kipman725/MegaPlateAmp/Sims/CurrentMonMorbid/gain_peaking.png

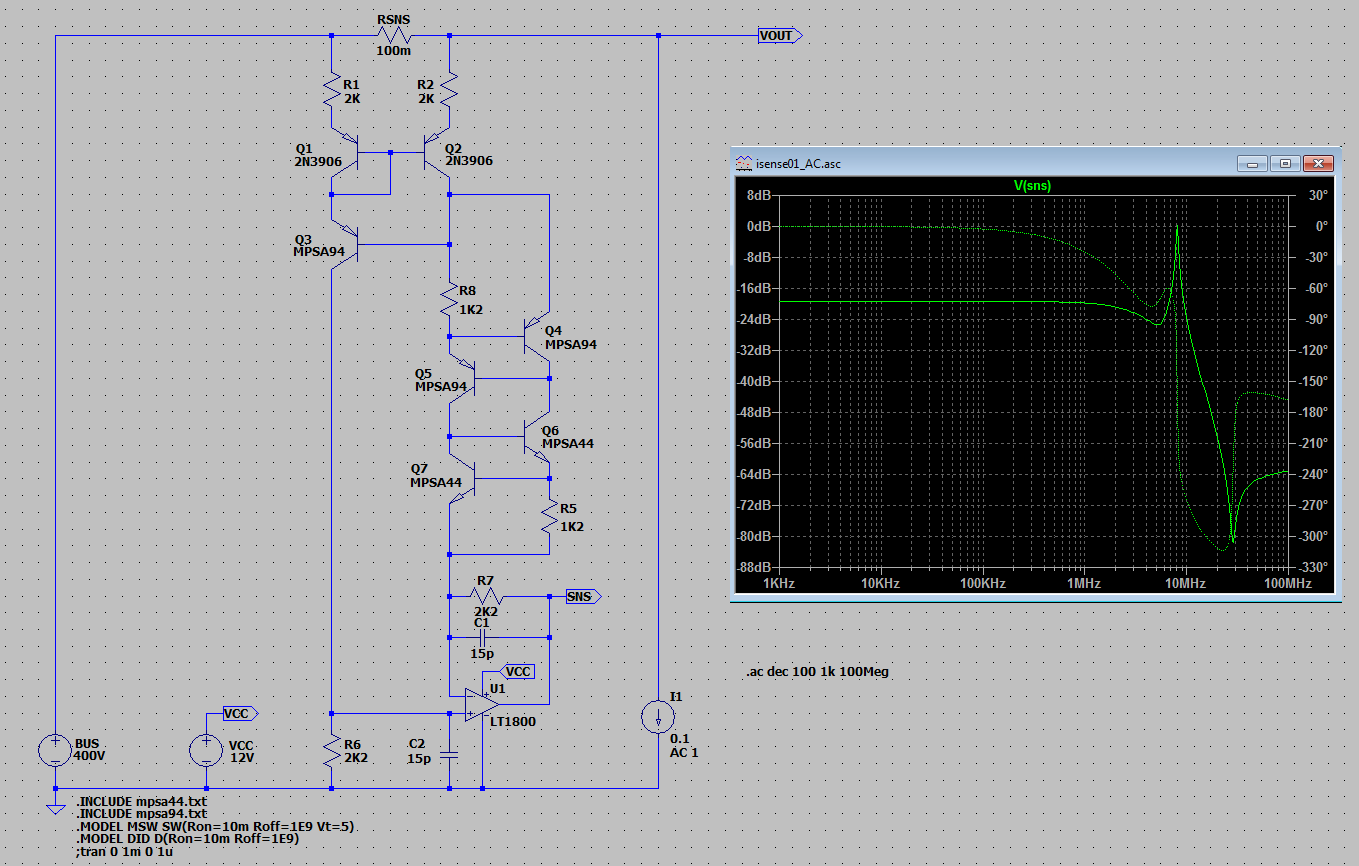
Sims/CurrentMonMorbid/gain_peaking.png
