kipman725/MegaPlateAmp/Sims/CurrentMonMorbid/linearity.png

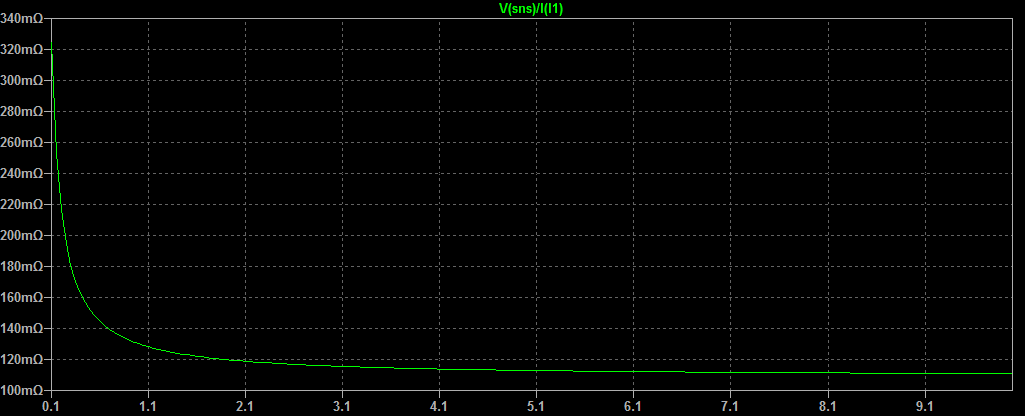
Sims/CurrentMonMorbid/linearity.png
