kipman725/MegaPlateAmp/MCU docs/LAUNCHXL_F28027_BOM.xls

Texas Instruments |  |  |  |  |  | Part Number | LAUNCHXL-F28027
Bill Of Materials for C2000 Launchpad |  |  |  |  |  | Asmbly Gnum
Bill Of Materials |  |  |  |  |  | Created | 2011-08-22
Item | Ref | Varient | Qty | Description | Notes | Mfg | Part Number | Vendor | Stk Number | Unit Cost | Line Cost
 | R12, R13, R14, R15, R26, R27 | All | 6 | RES 330 OHM 1/10W 5% 0402 SMD |  | Panasonic - ECG (http://digikey.com/Suppliers/us/Panasonic-Electronic-Components.page?lang=EN) | ERJ-2GEJ331X | Digikey | P330JTR-ND | 0.002 | 0.01
 | R1, R4, R5, R17 | All | 4 | RES 820 OHM 1/10W 5% 0402 SMD |  | Panasonic - ECG (http://digikey.com/Suppliers/us/Panasonic-Electronic-Components.page?lang=EN) | ERJ-2GEJ821X | Digikey | P820JTR-ND | 0.002 | 0.01
 | R22, R23 | All | 2 | RES 1.0K OHM 1/10W 5% 0402 SMD |  | Panasonic - ECG (http://digikey.com/Suppliers/us/Panasonic-Electronic-Components.page?lang=EN) | ERJ-2GEJ102X | Digikey | P1.0KJTR-ND | 0.002 | 0.0032
 | R6, R8, R9, R10, R31 | All | 5 | RES 2.2K OHM 1/10W 5% 0402 SMD |  | Panasonic - ECG (http://digikey.com/Suppliers/us/Panasonic-Electronic-Components.page?lang=EN) | ERJ-2GEJ222X | Digikey | P2.2KJTR-ND | 0.002 | 0.01
 | R11, R29 | All | 2 | RES 10K OHM 1/10W 5% 0402 SMD |  | Panasonic - ECG (http://digikey.com/Suppliers/us/Panasonic-Electronic-Components.page?lang=EN) | ERJ-2GEJ103X | Digikey | P10KJTR-ND | 0.002 | 0.0032
 | R24 | All | 1 | RES 12K OHM 1/16W .5% 0402 SMD |  | Panasonic - ECG (http://digikey.com/Suppliers/us/Panasonic-Electronic-Components.page?lang=EN) | ERA-2AED123X | Digikey | P12KDETR-ND | 0.026 | 0.03
 | R7 | All | 1 | RES 1.0M OHM 1/10W 5% 0402 SMD | No-pop | Panasonic - ECG (http://digikey.com/Suppliers/us/Panasonic-Electronic-Components.page?lang=EN) | ERJ-2GEJ105X | Digikey | P1.0MJTR-ND | 0.0016 | 0.0016
 | R16, R18, R19, R20, R21, R25, R28, R30, R32 | Non-Iso | 9 | RES 0.0 OHM 1/4W 1206 SMD |  | Panasonic - ECG (http://digikey.com/Suppliers/us/Panasonic-Electronic-Components.page?lang=EN) | ERJ-8GEY0R00V | Digikey | P0.0ETR-ND | 0.0023 | 0.02
 | L1, L2 | All | 2 | FERRITE BEAD 600 OHM 0402 |  | Taiyo Yuden (http://digikey.com/Suppliers/us/Taiyo-Yuden.page?lang=EN) | BK1005HM601-T | Digikey | 587-1839-2-ND | 0.012 | 0.02
 | L3 | All | 1 | FERRITE BEAD 220 OHM 0402 |  | Taiyo Yuden (http://digikey.com/Suppliers/us/Taiyo-Yuden.page?lang=EN) | BKP1005HS221-T | Digikey | 587-2088-1-ND | 0.02325 | 0.02
 | L4 | All | 1 | FERRITE CHIP 60 OHM 1.5A 0402 |  | TDK Corporation (http://digikey.com/Suppliers/us/TDK.page?lang=EN) | MPZ1005S600C | Digikey | 445-2980-2-ND | 0.018 | 0.02
 | C9, C12, C13, C14, C16 | All | 5 | CAP .10UF 16V CERAMIC Y5V 0402 |  | Yageo (http://digikey.com/Suppliers/us/Yageo.page?lang=EN) | CC0402ZRY5V7BB104 | Digikey | 311-1047-2-ND | 0.0012 | 0.01
 | C7 | All | 1 | CAP CER 1.0UF 6.3V X5R 20% 0402 |  | TDK Corporation (http://digikey.com/Suppliers/us/TDK.page?lang=EN) | C1005X5R0J105M | Digikey | 445-1415-2-ND | 0.004 | 0.004
 | C5, C6, C19, C20, C21 | All | 5 | CAP CER 2.2UF 6.3V 20% X5R 0402 |  | Taiyo Yuden (http://digikey.com/Suppliers/us/Taiyo-Yuden.page?lang=EN) | JMK105BJ225MV-F | Dugu | 587-1453-2-ND | 0.022 | 0.11
 | C15 | All | 1 | CAP CER 3.3UF 4.0V X5R 0402 |  | Taiyo Yuden (http://digikey.com/Suppliers/us/Taiyo-Yuden.page?lang=EN) | AMK105BJ335MV-F | Digikey | 587-2236-2-ND | 0.040 | 0.04
 | C10, C11 | All | 2 | CAP CER 4.7UF 4V X5R 0402 |  | Taiyo Yuden (http://digikey.com/Suppliers/us/Taiyo-Yuden.page?lang=EN) | AMK105BJ475MV-F | Digikey | 587-1966-2-ND | 0.058 | 0.12
 | C3, C4 | All | 2 | CAP CER 36PF 50V C0G 0402 | No-pop | TDK Corporation (http://digikey.com/Suppliers/us/TDK.page?lang=EN) | C1005C0G1H360J | Digikey | 445-4903-2-ND | 0.003 | 0.01
 | C17, C18 | All | 2 | CAP CER 36PF 50V C0G 0402 |  | TDK Corporation (http://digikey.com/Suppliers/us/TDK.page?lang=EN) | C1005C0G1H360J | Digikey | 445-4903-2-ND | 0.003 | 0.01
 | C8 | All | 1 | CAP TANTALUM 100UF 6.3V 10% SMD |  | Nichicon (http://digikey.com/Suppliers/us/Nichicon.page?lang=EN) | F930J107KBA | Digikey | 493-4109-2-ND | 0.116 | 0.12
 | F1 | All | 1 | PTC RESETTABLE .50A 15V 1812 |  | Bourns Inc. (http://digikey.com/Suppliers/us/Bourns.page?lang=EN) | MF-MSMF050-2 | Digikey | MF-MSMF050-2TR-ND | 0.071 | 0.07
 | S1 | All | 1 | SWITCH DIP 3POS TOP SLIDE SMT |  | CTS Electrocomponents (http://digikey.com/Suppliers/us/CTS-Corporation-Electrocomponents.page?lang=EN) | 204-3ST | Digikey | CT2043ST-ND | 0.491 | 0.49
 | S4 | All | 1 | SWITCH DIP DPST 1POS SMT |  | CTS Electrocomponents (http://digikey.com/Suppliers/us/CTS-Corporation-Electrocomponents.page?lang=EN) | 204-211ST | Digikey | CT204211ST-ND | 0.486 | 0.49
 | S2, S3 | All | 2 | SW TACT SPST-NO MOM 160GF SMD |  | TE Connectivity (http://digikey.com/Suppliers/us/Tyco-Electronics-Alcoswitch.page?lang=EN) | FSM2JSMATR | Digikey | 450-1757-2-ND | 0.117 | 0.23
 | Q1, Q2 | All | 1 | Crystal | No-pop |  |  |  |  | 0.000 | 0.00
 | Q3 | All | 1 | CRYSTAL 12.0000 MHZ 18PF SMD |  | Abracon Corporation (http://digikey.com/Suppliers/us/Abracon.page?lang=EN) | ABLS2-12.000MHZ-D4Y-T | Digikey | 535-9869-2-ND | 0.204 | 0.20
 | D6 | All | 1 | LED RED HIGH BRIGHT ESS SMD |  | Panasonic - SSG (http://digikey.com/Suppliers/us/Panasonic-Semiconductors.page?lang=EN) | LNJ237W82RA | Digikey | LNJ237W82RATR-ND | 0.045 | 0.04
 | D1 | All | 1 | LED GREEN HIGH BRIGHT ESS SMD |  | Panasonic - SSG (http://digikey.com/Suppliers/us/Panasonic-Semiconductors.page?lang=EN) | LNJ337W83RA | Digikey | LNJ337W83RATR-ND | 0.06 | 0.06
 | D2, D3, D4, D5, D7, D8 | All | 6 | LED BLUE HIGH BRIGHT ESS SMD |  | Panasonic - SSG (http://digikey.com/Suppliers/us/Panasonic-Semiconductors.page?lang=EN) | LNJ937W8CRA | Digikey | LNJ937W8CRATR-ND | 0.08 | 0.48
 |  | All |  |  |  |  |  |  |  |  | 0.00
 | JP1, JP2, JP3 | Iso | 3 | BERGSTIK II .100" SR STRAIGHT |  | FCI (http://digikey.com/Suppliers/us/FCI.page?lang=EN) | 68001-102HLF | Digikey | 609-3506-ND | 0.08 | 0.24
 | J1 & J5, J2 & J6 | All | 2 | CONN HEADER .100 DUAL STR 20POS |  | 3M (http://digikey.com/Suppliers/us/3M.page?lang=EN) | 929665-03-10-I | Digikey | 929665-03-10-ND | 3.1 | 6.20
 | J3 | All | 1 | CONN HEADER .100 SNGL STR 3POS |  | 3M (http://digikey.com/Suppliers/us/3M.page?lang=EN) | 929647-03-03-I | Digikey | 929647-03-03-ND | 0.88 | 0.88
 | CON1 | All | 1 | CONN RECEPT MINI-USB TYPE B SMT |  | Mill-Max Manufacturing Corp. (http://digikey.com/Suppliers/us/Mill-Max.page?lang=EN) | 897-43-005-00-100001 | Digikey | ED90341TR-ND | 0.44 | 0.44
 |  | All |  |  |  |  |  |  |  |  | 0.00
 | U4 | All | 1 | IC LDO REG 800MA 3.3V SOT223-4 |  | Texas Instruments (http://digikey.com/Suppliers/us/Texas-Instruments.page?lang=EN) | TLV1117-33CDCYR | Digikey | 296-21112-2-ND | 0.192 | 0.19
 | U2, U3 | All | 2 | IC BUFF/DVR DL NON-INV SOT236 |  | Texas Instruments (http://digikey.com/Suppliers/us/Texas-Instruments.page?lang=EN) | SN74LVC2G07DBVR | Digikey | 296-13494-2-ND | 0.083 | 0.17
 | U5 | All | 1 | ISOLAT DGTL 2.5KVRMS 4CH 16-SOIC |  | Texas Instruments (http://digikey.com/Suppliers/us/Texas-Instruments.page?lang=EN) | ISO7240CDWR | Digikey | ISO7240CDWR-ND | 1.912 | 1.91
 | U7 | All | 1 | ISOLAT DGTL 3KVRMS 3CH 16-SOIC |  | Texas Instruments (http://digikey.com/Suppliers/us/Texas-Instruments.page?lang=EN) | ISO7231CDWR | Digikey | ISO7231CDWR-ND | 1.51 | 1.51
 | U6 | All | 1 | IC USB HS DUAL UART/FIFO 64-QFN |  | FTDI, Future Technology Devices International Ltd (http://digikey.com/Suppliers/us/Future-Technology-Devices.page?lang=EN) | FT2232HQ-REEL | Digikey | 768-1025-2-ND | 3.6 | 3.60
 | U8 | All | 1 | IC EEPROM 2KBIT 3MHZ SOT23-6 |  | Microchip Technology (http://digikey.com/Suppliers/us/Microchip-Technology.page?lang=EN) | 93LC56BT-I/OT | Digikey | 93LC56BT-I/OTTR-ND | 0.2 | 0.20
 | U1 | All | 1 | IC MCU 32BIT 64KB FLASH 48LQFP |  | Texas Instruments (http://digikey.com/Suppliers/us/Texas-Instruments.page?lang=EN) | TMS320F28027PTS | Digikey | TMS320F28027PTS-ND | 4.020 | 4.02
 |  |  | 1 |  |  |  |  |  |  |  | 0.00 | - | 7.80 | = | 14.18
 |  |  |  |  |  |  |  |  |  |  | 21.98
Note: All Items with Texas Instruments listed as vendor will be consigned by Texas Instruments
