kipman725/MegaPlateAmp/PCB/ECAD/LM2776DBVR.stp

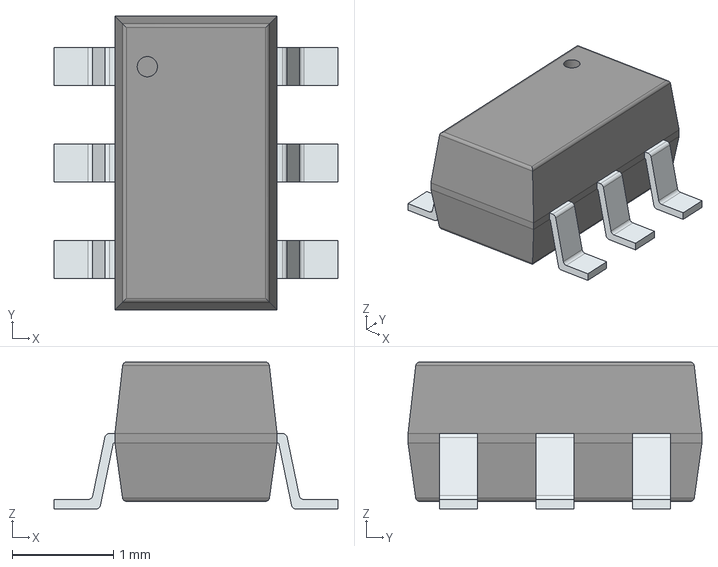
[picture p16: CAD file, 2020-05-20]
PCB/ECAD/LM2776DBVR.stp
2.80 x 2.90 x 1.45 mm
PinsArrayLR
