kipman725/MegaPlateAmp/PCB/ECAD/DST3906DJ-7.stp

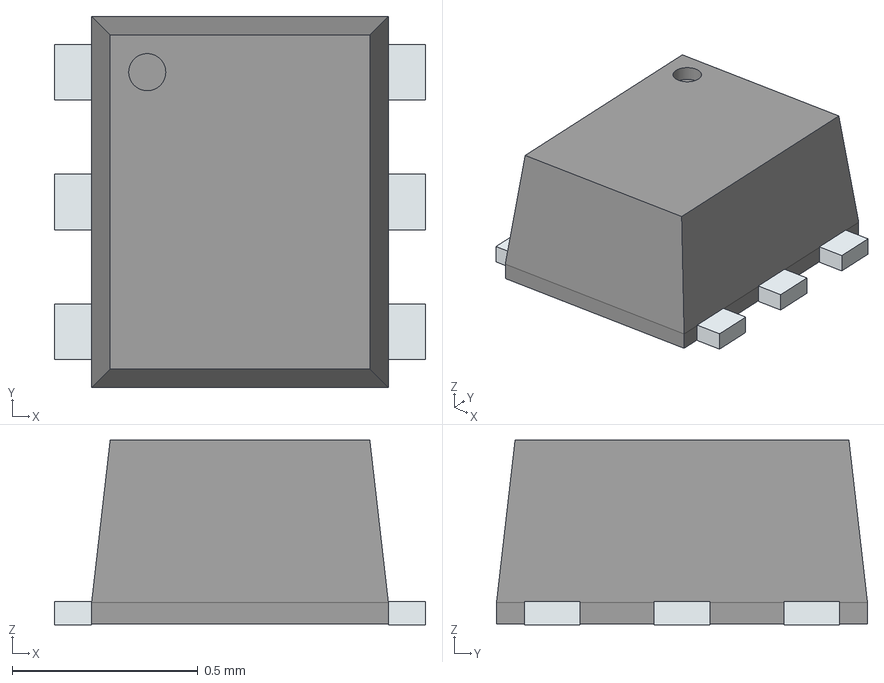
[picture p17: CAD file, 2020-05-20]
PCB/ECAD/DST3906DJ-7.stp
1.00 x 1.00 x 0.498 mm
PinsArrayL
PinsArrayR
