kipman725/MegaPlateAmp/PCB/ECAD/TMS320F28027FPTT.stp

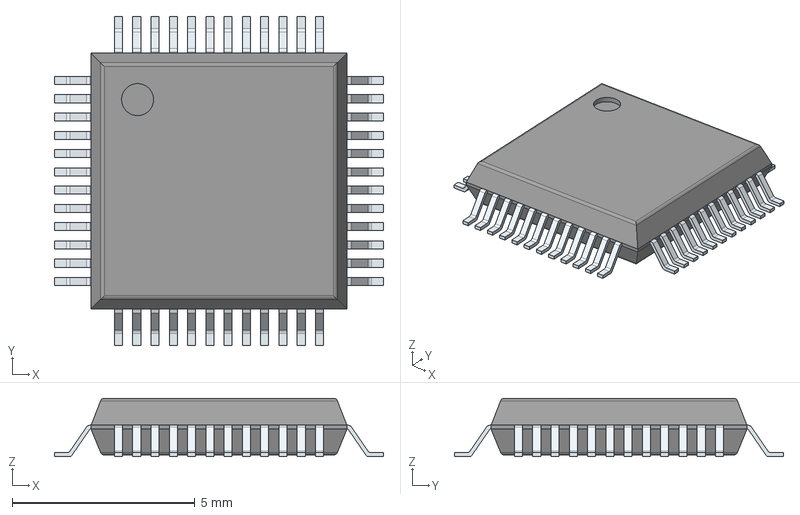
[picture p18: CAD file, 2020-05-20]
PCB/ECAD/TMS320F28027FPTT.stp
9.00 x 9.00 x 1.60 mm
PinsArrayLR
PinsArrayTB
