kipman725/MegaPlateAmp/PCB/ECAD/ALC70C332FP350.stp

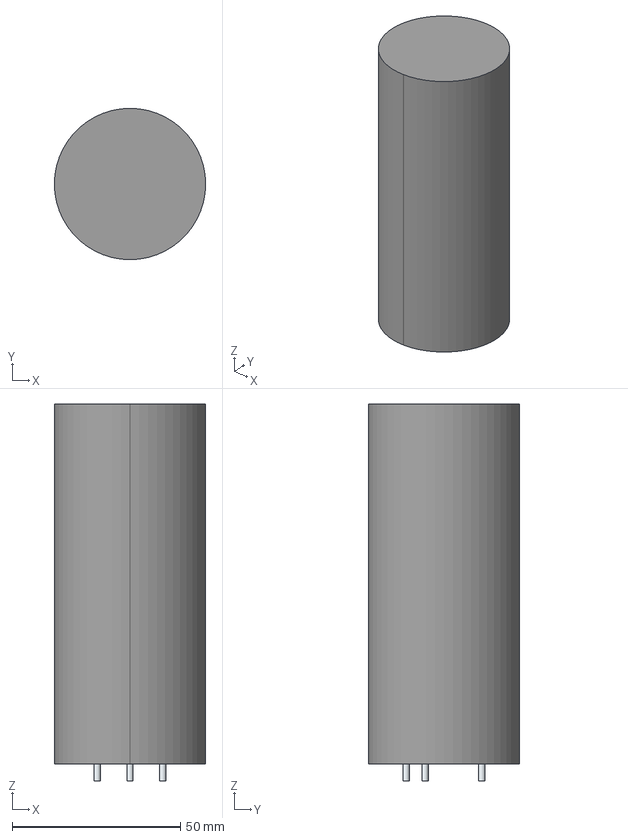
[picture p19: CAD file, 2020-04-15]
PCB/ECAD/ALC70C332FP350.stp
45.0 x 45.0 x 112.1 mm
Leads x 4
