kipman725/MegaPlateAmp/PCB/ECAD/74437529203221.stp

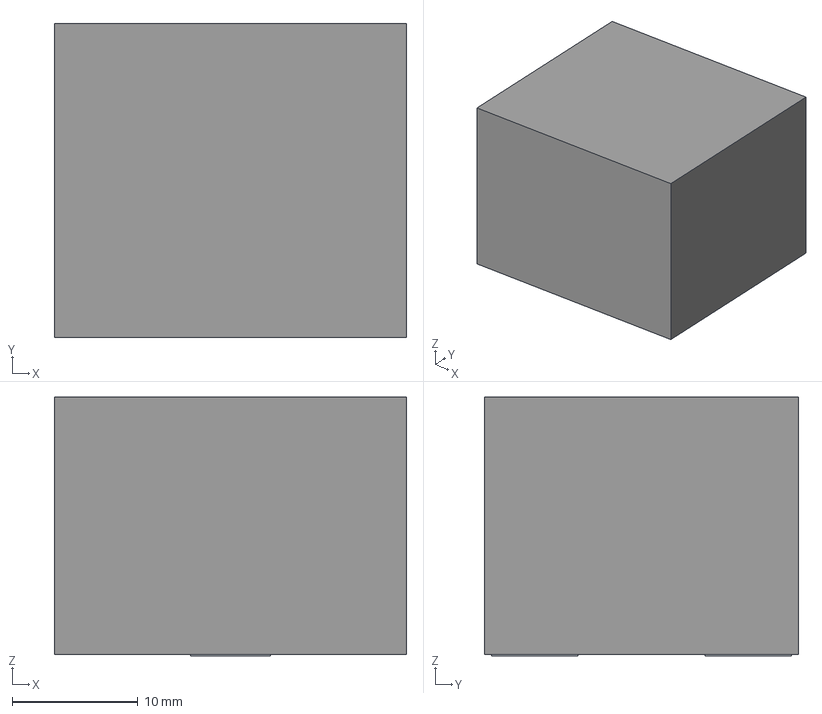
[picture p20: CAD file, 2020-05-20]
PCB/ECAD/74437529203221.stp
28.0 x 25.0 x 20.6 mm
Pins
