kipman725/MegaPlateAmp/(list of files, cad)

Other CAD files:
PCB/ECAD/TPS70950DBVR.stp
PCB/ECAD/74437529203221.stl
PCB/ECAD/ALC70C332FP350.stl
PCB/ECAD/DST3906DJ-7.stl
PCB/ECAD/LM2776DBVR.stl
PCB/ECAD/SI8274GB1-IM1.stl
PCB/ECAD/TMS320F28027FPTT.stl
PCB/ECAD/TPS70950DBVR.stl
