kipman725/MegaPlateAmp/Documentation/basic_diagram.pdf

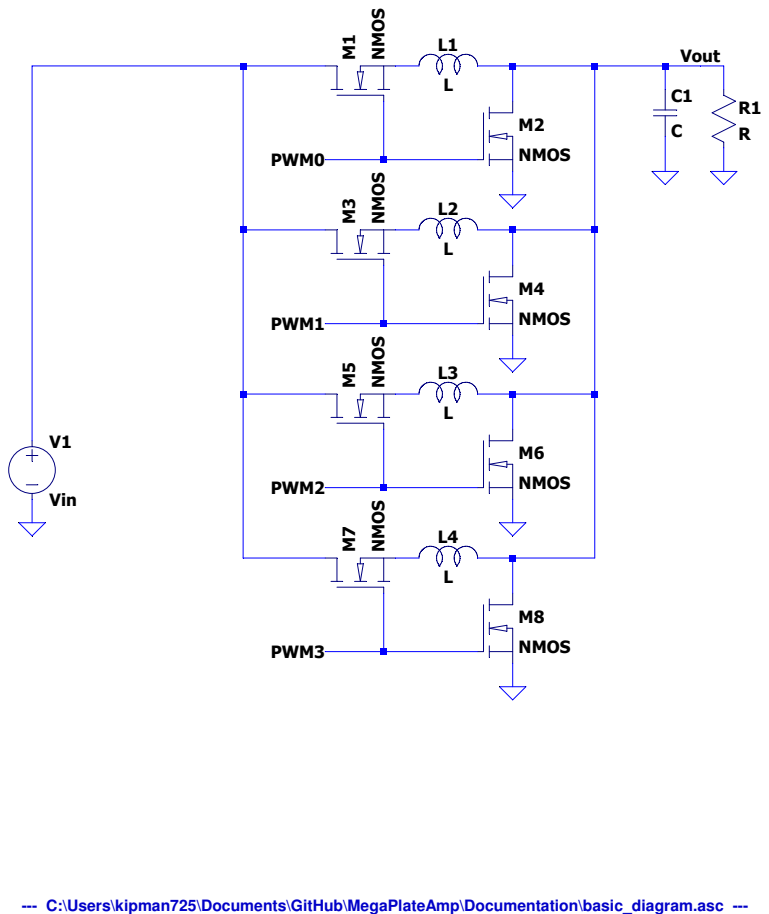
[picture p21: page 1]
NMOS; Vin; PWM0; PWM1; PWM2; PWM3; Vout

--- C:\Users\kipman725\Documents\GitHub\MegaPlateAmp\Documentation\basic_diagram.asc ---
