kipman725/MegaPlateAmp/Sims/GaNSystems/GN008_GANSYS_Half_Bridge_Switching_Test_v2.asc

C1: cap; 100µ
C13: cap; 2µ
L1: ind; {L_DPT}; Rser=10m
L2: ind; {L_GATE}
L4: ind; {L_GATE}
L5: ind; {L_GATE}
L6: ind; {L_GATE}
L7: ind; {LS_EX}
L8: ind; 2n
L9: ind; { LS_EX}
L10: ind; 2n
L11: ind; {L_DS}; Rser=20m
L12: ind; 10µ
L13: ind; 10µ
L14: ind; {L_DS}; Rser=20m
R1: res; {Rgon}
R2: res; {Rgoff}
R10: res; {Rgon}
R11: res; {Rgoff}
S1: sw; SW_GDH
S2: sw; SW_GDL
S3: sw; SW_GDH
S4: sw; SW_GDL
U3: GaN_LTspice_GS-065-011-1-L_L1V4P1
U4: GaN_LTspice_GS-065-011-1-L_L1V4P1
V1: voltage; {VBUS}
V2: voltage; PULSE(-1 1 {DT} 1n 1n {T_ON-2*DT} {T_P} 2)
V3: voltage; PULSE(1 -1 0 1n 1n {T_ON} {T_P} 2)
V4: voltage; {VDRV_P}
V5: voltage; {VDRV_N}
V6: voltage; {VDRV_P}
V7: voltage; {VDRV_N}
Named nets: vGSP_LSS, pwm_LSS, 0, DRV+, DRV-, DRV+_H, DRV-_H, gh, HSD, VSW
.tran 0 3U 0 0.1n
.param VDRV_P = 6; Turn-on gate voltage
.param VDRV_N=0 ; Turn-off gate voltage
.param DT = 30n; dead time
.param T_ON = 2U; Turn-on period
.param L_DPT = VBUS * (T_ON-2*DT) / ISW ; calculated L for switching current
.param T_P = 2.5U; total period
.param L_GATE =3N; gate inductance
.param LS_EX= 10p; external source inductance
.param L_DS =2N; power loop inductance
.option ITL1=500
.option ITL2=500
.option ITL4=500
.option RELTOL=0.01
.option ABSTOL=1E-09
.option CHGTOL=1E-12
.option VNTOL=1E-6
.option GMIN=1E-15
.option TRTOL=1
.option noopiter
.option gminsteps=0
.option topologycheck=0
 
.option temp=25; Set Tj
.model SW_GDH VSWITCH Roff=1e6 Ron=2 Voff=0 Von=1
.model SW_GDL VSWITCH Roff=1e6 Ron=.4 Voff=0 Von=1
GAN SYSTEMS SWITCHING LOSS DOUBLE PULSE TEST BENCH
.param VBUS = 400; DC bus voltage
.param ISW = 4; Switching Current
.param RGON=15 ; Turn-on Gate Resistor
.param RGOFF=2 ; Turn-off Gate Resistor
