kipman725/MegaPlateAmp/Sims/GaNSystems/HB_TEST_GAN.asc

U1: GaN_LTspice_GS-065-011-1-L_L1V4P1
U3: GaN_LTspice_GS-065-011-1-L_L1V4P1
V1: voltage; 390
V3: voltage; PULSE(0 5 0 25n 25n 2.375u 5u)
V4: voltage; PULSE(0 5 2.5u 25n 25n 2.375u 5u)
Named nets: 0
.tran 0 1m 0 10n
.option temp=25; Set Tj
.option ITL1=500
.option ITL2=500
.option ITL4=500
.option RELTOL=0.01
.option ABSTOL=1E-9
.option CHGTOL=1E-12
.option VNTOL=1E-6
.option GMIN=1E-15
.option TRTOL=1
.option noopiter
.option gminsteps=0
.opton topologycheck=0
