kipman725/MegaPlateAmp/Sims/Onsemi_test/HB_TEST.asc

C1: cap; 100µ; IC=195V
L1: ind; 470µ
R1: res; 50
U1: FCMT125N65S3_4p
U2: FCMT125N65S3_4p
V1: voltage; 390
V3: voltage; PULSE(0 12 0 25n 25n 2.375u 5u)
V4: voltage; PULSE(0 12 2.5u 25n 25n 2.375u 5u)
Named nets: 0
.INCLUDE ONSEMI_SUPERFET3_650_ltspice.txt
.tran 0 200u 100u 10n
