kipman725/MegaPlateAmp/Sims/Onsemi_test/ONSemiTest.asc

R1: res; 20
R2: res; 2.2
U1: FCMT125N65S3_4p
V1: voltage; PULSE(0 10 1u 10n 10n 1u 3u)
V2: voltage; 390
Named nets: 0
.INCLUDE ONSEMI_SUPERFET3_650_ltspice.txt
.tran 0 10u 0 10n
