kipman725/MegaPlateAmp/Documentation/basic_diagram.asc

C1: cap
L1: ind
L2: ind
L3: ind
L4: ind
M1: nmos
M2: nmos
M3: nmos
M4: nmos
M5: nmos
M6: nmos
M7: nmos
M8: nmos
R1: res
V1: voltage; Vin
Named nets: 0, PWM0, PWM1, PWM2, PWM3, Vout
