kipman725/MegaPlateAmp/Sims/CurrentMonMorbid/isense01_neg_rail_AC.asc

BUS: voltage; 400V
C1: cap; 15p
I1: current; 0.1; AC 1
Q1: pnp; 2N3906
Q2: pnp; 2N3906
Q3: pnp; MPSA94
Q4: pnp; MPSA94
Q5: pnp; MPSA94
Q6: npn; MPSA44
Q7: npn; MPSA44
R1: res; 220
R2: res; 220
R5: res; 1K2
R6: res; 2K2
R7: res; 2K2
R8: res; 1K2
RSNS: res; 22m
U1: LT1805
VCC: voltage; 5V
VEE: voltage; -5V
Named nets: SNS, 0, VOUT, VCC, VEE
.MODEL MSW SW(Ron=10m Roff=1E9 Vt=5)
.MODEL DID D(Ron=10m Roff=1E9)
;tran 0 1m 0 1u
.INCLUDE mpsa44.txt
.INCLUDE mpsa94.txt
.ac dec 100 1k 100Meg
