kipman725/MegaPlateAmp/Sims/GaNSystems/PWR_STAGE_LOSS.asc

A1: diffschmitt
A2: and
A3: and
C1: cap; 10µ; IC={output_v}
D1: diode; mss1p3l
D2: diode; mss1p3l
E1: e; {gd_volt}
E2: e; {gd_volt}
L1: ind; 470µH
R1: res; 2
R2: res; 50
R3: res; 50
R4: res; 15
R5: res; 2
R6: res; 15
R7: res; {Rload}
R8: res; 115m
T1: tline; Td={dt} Z0=50
T2: tline; Td={dt} Z0=50
U1: GaN_LTspice_GS-065-011-1-L_L1V4P1
U2: GaN_LTspice_GS-065-011-1-L_L1V4P1
V1: voltage; {dcbus}; Rser=10m
V2: voltage; PULSE(0 1 0 10n 10n {duty/fsw} {1/fsw})
VStartupDelay: voltage; PULSE(0 1 1u 10n 10n 9999)
Named nets: 0, HS, LS
.tran 0 4m 3m 1n
.model LimiterDiode D(Ron=1m Roff=1Meg Vfwd={dcbus})
.model SW_D D(Ron=1m Roff=1Meg Vfwd=0.2 Vrev=3000)
.model AMPSW SW(Ron=1m Roff=10Meg Vt=.5 Vh=-.4)
.param fsw=1e6 dt=35n dcbus=390 output_v=300 output_I=1 duty=output_v/dcbus Rload=output_v/output_I gd_volt=6
Deadtime generation
.option temp=25; Set Tj
.option ITL1=500
.option ITL2=500
.option ITL4=500
.option RELTOL=0.01
.option ABSTOL=1E-9
.option CHGTOL=1E-12
.option VNTOL=1E-6
.option GMIN=1E-15
.option TRTOL=1
.option noopiter
.option gminsteps=0
.opton topologycheck=0
.subckt mss1p3l 1 2
ddio 1 2 legd
dgr 1 2 grd
.model legd d is = 1.16736E-008 n = 0.951088 rs = 0.140179
+ eg = 0.400064 xti = 0.5012 tnom = 27
+ cjo = 1.66308E-010 vj = 0.700989 m = 0.467798 fc = 0.5
+ tt = 2.4663E-010 bv = 33 ibv = 0.1 af = 1 kf = 0
.model grd d is = 1.74803E-007 n = 0.906853 rs = 0.115937
+ eg = 0.66454 xti = 1.71799 tnom = 27
.ends
Output capcitance reduced to speed up convergance
