kipman725/MegaPlateAmp/Sims/bass_hit_analysis/BassHitAnalysis.asc

A1: diffschmitt; Vt=10m; trise=10n; tfall=10n
A2: and
A3: and
C1: cap; 10m
C2: cap; 2.813µF
C3: cap; 2.813µF
D1: diode; LimiterDiode
D2: diode; SW_D
D3: diode; SW_D
D4: diode; SW_D
D5: diode; SW_D
E1: e; {gain}
I1: current; 12A
L1: ind; 45.02µH
L2: ind; 45.02µH
R1: res; {Rload}
R2: res; 50
R3: res; 50
R4: res; 100m
S1: sw; AMPSW
S2: sw; AMPSW
S3: sw; AMPSW
S4: sw; AMPSW
T1: tline; Td={dt} Z0=50
T2: tline; Td={dt} Z0=50
V1: voltage; wavefile=Glue_120Hz_bass.wav chan=0
VStartupDelay: voltage; PULSE(0 1 1u 10n 10n 9999)
VTriangle: voltage; PULSE(-1 1 0 {0.5/fsw} {0.5/fsw} 0 {1/fsw})
Named nets: 0, SW_PAIR_0, SW_PAIR_1
.tran 0 0.47 1m 100n
.model LimiterDiode D(Ron=1m Roff=1Meg Vfwd={dcbus})
.model SW_D D(Ron=1m Roff=1Meg Vfwd=0.2 Vrev=3000)
.model AMPSW SW(Ron=1m Roff=10Meg Vt=.5 Vh=-.4)
Current limited supply with energy storage
.param fsw=50e3 dt=250n rload=1 gain=1.25 dcbus=150
Class D signal generation
.step param rload list 1 2 4 8
