kipman725/MegaPlateAmp/Sims/bass_hit_analysis/WaveFile_exam.asc

E1: e; {gain}
R1: res; 1
V1: voltage; wavefile=Glue_120Hz_bass.wav chan=0
Named nets: 0
.param gain=1.25
.tran 0 1 0 20u
