kipman725/MegaPlateAmp/Sims/basic_buck/QuadPhase.asc

A1: dflop; trise=10n; tfall=10n
A2: dflop; trise=10n; tfall=10n
A3: and; trise=10n; tfall=10n
A4: dflop; trise=10n; tfall=10n
A5: and; trise=10n; tfall=10n
A6: dflop; trise=10n; tfall=10n
A7: and; trise=10n; tfall=10n
A10: and; trise=10n; tfall=10n
C1: cap; 33n
C2: cap; 10p
Co: cap; 100µ
D1: schottky; RBR5L40A
D2: schottky; RBR5L40A
D3: schottky; RBR5L40A
D4: schottky; RBR5L40A
E1: e; 5
E2: e; 10
E3: e; 1
E4: e; 5
E5: e; 10
E6: e; 5
E7: e; 10
E8: e; 5
E9: e; 10
E10: e; 1
E11: e; 1
E12: e; 1
L1: ind; 100µ; Rser=0.115 Cpar=7.036p
L2: ind; 100µ; Rser=0.115 Cpar=7.036p
L3: ind; 100µ; Rser=0.115 Cpar=7.036p
L4: ind; 100µ; Rser=0.115 Cpar=7.036p
M1: nmos; BSZ0920NS
M2: nmos; BSZ0920NS
M3: nmos; BSZ0920NS
M4: nmos; BSZ0920NS
R1: res; 10k
R2: res; 5
R3: res; 100m
R4: res; 5
R5: res; 100m
R6: res; 5
R7: res; 100m
R8: res; 10k
R9: res; 2.232k
R10: res; 1m
R11: res; 5
R12: res; 100m
R13: res; 5
U1: UniversalOpamp2; Avol=10Meg GBW=10Meg Slew=10Meg
U2: UniversalOpamp2; Avol=10Meg GBW=10Meg Slew=10Meg
U3: UniversalOpamp2; Avol=10Meg GBW=10Meg Slew=10Meg
U4: UniversalOpamp2; Avol=10Meg GBW=10Meg Slew=10Meg
U5: UniversalOpamp2; Avol=10Meg GBW=10Meg Slew=10Meg
V1: voltage; PULSE(0 0.7 625n 9.99u 10n 0 10u)
V2: voltage; 10
V3: voltage; 1
V4: voltage; 1
V5: voltage; 1.25
V6: voltage; PULSE(0 1 0 10n 10n 5u 10u)
V7: voltage; PULSE(1 0 9.375u 10n 10n 625n 10u)
V8: voltage; 1
V9: voltage; 1
V10: voltage; PULSE(0 1 2.5u 10n 10n 5u 10u)
V11: voltage; PULSE(1 0 11.875u 10n 10n 625n 10u)
V12: voltage; PULSE(0 0.7 3.125u 9.99u 10n 0 10u)
V13: voltage; 1
V14: voltage; 1
V15: voltage; PULSE(0 1 5u 10n 10n 5u 10u)
V16: voltage; PULSE(1 0 14.375u 10n 10n 625n 10u)
V17: voltage; PULSE(0 0.7 5.625u 9.99u 10n 0 10u)
V18: voltage; 1
V19: voltage; 1
V20: voltage; PULSE(0 1 7.5u 10n 10n 5u 10u)
V21: voltage; PULSE(1 0 16.875u 10n 10n 625n 10u)
V22: voltage; PULSE(0 0.7 8.125u 9.99u 10n 0 10u)
V23: voltage; 1
Named nets: 0, Isense_0, fs_0, blank_0, Vsense, ramp_0, VCTL_SIG, G0, Isense_1, G1, Isense_2, G2, Isense_3, G3, blank_1, fs_1, ramp_1, blank_2, fs_2, ramp_2, fs_3, blank_3, ramp_3
.tran 0 1m 1u 10n
Design Vo=7V, Ilim=1A
Compensating ramp generator
Ramp voltage set for D=0.7V from NXP datasheet
Summing junction
Compensator and voltage sense amp
Compensating ramp generator
Ramp voltage set for D=0.7V from NXP datasheet
Summing junction
Compensating ramp generator
Ramp voltage set for D=0.7V from NXP datasheet
Summing junction
Compensating ramp generator
Ramp voltage set for D=0.7V from NXP datasheet
Summing junction
