kipman725/MegaPlateAmp/Sims/CurrentMonMorbid/isense01.asc

BUS: voltage; 400V
C1: cap; 15p
C2: cap; 15p
CFILT: cap; 220µ; IC=360V
DCA: diode; DID
DRV: voltage; PULSE(0 12 0 10n 10n 9u 10u)
LFA: ind; 20µ
Q1: pnp; 2N3906
Q2: pnp; 2N3906
Q3: pnp; MPSA94
Q4: pnp; MPSA94
Q5: pnp; MPSA94
Q6: npn; MPSA44
Q7: npn; MPSA44
R1: res; 2K
R2: res; 2K
R5: res; 1K2
R6: res; 2K2
R7: res; 2K2
R8: res; 1K2
RLOAD: res; 72R
RSNS: res; 100m
S1: sw; MSW
U1: LT1800
VCC: voltage; 12V
Named nets: DRV, SNS, 0, VOUT, VCC
.MODEL MSW SW(Ron=10m Roff=1E9 Vt=5)
.MODEL DID D(Ron=10m Roff=1E9)
.tran 0 100.05m 100m 100n
.INCLUDE mpsa44.txt
.INCLUDE mpsa94.txt
