kipman725/MegaPlateAmp/Sims/basic_buck/ACmodel.asc

C1: cap; {Co}
E1: e; {Km}
E2: e; {{GI}*{Hs}}
E3: e; {Gv}
L1: ind; {L}
R1: res; {Rl}
R2: res; {Rs}
R3: res; {Rc}
R4: res; {Ro}
V2: voltage; ""; AC 1
Named nets: 0, Vo
.param Km=10 L=100u Rs=100m Gi=1 Co=100u Rc=0.028 Ro=7 Hs=1 Gv=10e6 Rl=100m
.ac oct 100 100 10meg
This is not correct!
