kipman725/MegaPlateAmp/Sims/basic_buck/Dtype_Latch_limit.asc

16fs: voltage; PULSE(0 1 0 10n 10n 312.5n 625n)
A1: dflop; trise=10n; tfall=10n
A2: schmitt; vt=1; vh=0.01
A3: dflop; trise=10n; tfall=10n
A4: dflop; trise=10n; tfall=10n
A5: dflop; trise=10n; tfall=10n
A6: dflop; trise=10n; tfall=10n
A7: and
A8: and
A9: and
A10: and; trise=10n; tfall=10n
C1: cap; 100µ; Rser=1m
C2: cap; 15.9nF
D1: schottky; RBR5L40A
E1: e; 5
E2: e; 10
E3: e; 1
L1: ind; 100µ; Rser=0.115 Cpar=7.036p
M1: nmos; BSZ0920NS
R1: res; 3
R2: res; 5
R3: res; 100m
R4: res; 10k
R5: res; 10k
R6: res; 10k
R7: res; 10k
R8: res; 10k
V1: voltage; PULSE(0 0.52 625n 9.99u 10n 0 10u)
V2: voltage; 10
V3: voltage; 1
Named nets: 0, Isense, fs, logic_1, blank, ramp
.tran 0 10m 1u 10n
Blanking pulse prevents >0.9375 duty cycle
and resets the ramp compensating ramp generator
Pulse happens in final 1/16th of switching period
100kHz buck
Compensating ramp generator
Ramp voltage set for D=0.7V from NXP datasheet
