kipman725/MegaPlateAmp/Sims/basic_buck/triangle_gen.asc

A1: inv; trise=10n; tfall=10n
A8: dflop; trise=10n; tfall=10n
A9: and
A10: and
A11: and
A12: dflop; trise=10n; tfall=10n
A13: dflop; trise=10n; tfall=10n
A14: dflop; trise=10n; tfall=10n
C1: cap; 14.7nF; IC=2.5
Q1: npn; 2N2222
Q2: npn; 2N2222
R1: res; 10
R2: res; 4.2k
R5: res; 10k
R6: res; 10k
R7: res; 10k
R8: res; 10k
S1: sw; MYSW
U1: AD8065
V1: voltage; 5
V2: voltage; 5
V3: voltage; 2.7
V4: voltage; PULSE(0 1 0 10n 10n 312.5n 625n)
Named nets: 0, Vout, blank, fs
.tran 0 100u 0 10n
.model MYSW SW(Ron=4m Roff=100Meg Vt=.5 Vh=-.4)
Blanking pulse prevents >0.9375 duty cycle
and resets the ramp compensating ramp generator
Pulse happens in final 1/16th of switching period
100kHz buck
