kipman725/MegaPlateAmp/Sims/basic_buck/VoltageLoopSwitchedLoad.asc

16fs: voltage; PULSE(0 1 0 10n 10n 312.5n 625n)
A1: dflop; trise=10n; tfall=10n
A3: dflop; trise=10n; tfall=10n
A4: dflop; trise=10n; tfall=10n
A5: dflop; trise=10n; tfall=10n
A6: dflop; trise=10n; tfall=10n
A7: and
A8: and
A9: and
A10: and; trise=10n; tfall=10n
C1: cap; 33n
C2: cap; 10p
Co: cap; 100µ
D1: schottky; RBR5L40A
E1: e; 5
E2: e; 10
E3: e; 1
L1: ind; 100µ; Rser=0.115 Cpar=7.036p
M1: nmos; BSZ0920NS
R1: res; 10k
R2: res; 5
R3: res; 100m
R4: res; 10k
R5: res; 10k
R6: res; 10k
R7: res; 10k
R8: res; 10k
R9: res; 2.232k
R10: res; 1m
R11: res; 1
Rl: res; 20
S1: sw; MYSW
U1: UniversalOpamp2; Avol=10Meg GBW=10Meg Slew=10Meg
U2: UniversalOpamp2; Avol=10Meg GBW=10Meg Slew=10Meg
V1: voltage; PULSE(0 0.7 625n 9.99u 10n 0 10u)
V2: voltage; 10
V3: voltage; 1
V4: voltage; 1
V5: voltage; 1.25
V6: voltage; 1
V7: voltage; PULSE(0 1 5m 10n 10n 2m)
Named nets: 0, Isense, fs, logic_1, blank, ramp, Vsense
.tran 0 10m 1u 10n
Blanking pulse prevents >0.9375 duty cycle
and resets the ramp compensating ramp generator
Pulse happens in final 1/16th of switching period
100kHz buck
Compensating ramp generator
Ramp voltage set for D=0.7V from NXP datasheet
Design Vo=7V, Ilim=1A
To limit the output current the voltage amplifier should not be allowed to exceed the current threshold
.model MYSW SW(Ron=1m Roff=1Meg Vt=.5 Vh=-.4)
Summing junction
