kipman725/MegaPlateAmp/(commit log)

2020-04-05 initial commit
    initial commit
    [Amplifier.sch, BUCK_CONTROL.sch, BUCK_CONTROL_SAW.sch, Buck.sch, MegaPlateAmp.kicad_pcb, MegaPlateAmp.sch, PFC.sch]
2020-04-13 Schematics update
    Did some more work on the schematics for the buck development board
    [BuckDevel.kicad_pcb, BuckDevel.sch, BuckThermal.xlsx, SI8274GB1-IM1.stl, SI8274GB1-IM1.stp, TPS70950DBVR.stl, TPS70950DBVR.stp]
2020-04-15 Bass hit analysis
    I did an analysis of how bass hits will affect the power rails
    [ALC70C332FP350.stl, ALC70C332FP350.stp, BuckDevel.sch, Class-D LC Filter Designer.xlsx]
2020-05-20 pending updates mostly mcu schematic
    [74437529203221.stl, 74437529203221.stp, BUCK_MCU.sch, BuckDevel.sch, BuckThermal.xlsx, DST3906DJ-7.stl, DST3906DJ-7.stp, ISENSEsch.sch]
